ramanan849/Makerspace101_UTM_Monster/README.md

# Makerspace101 (MS101) Course Project 
[Project Report](https://github.com/ramanan849/Makerspace101_UTM_Monster/blob/47e68d466ecf8d2956a00e4f3acc10e7f7961b5e/B10_I_Project_report.pdf)
Course Project - MS101 - Autumn 2023-24 : Oct '23 to Nov '23
- Professors : Prof. Joseph John (EE), Prof. Arunkumar Sridharan (ME), Prof. Krishna N. Jonnalagadda (ME) and Prof. Janani Sree Muralidharan (ME)
- Team D2/B10/I
  Team Members:
  1. Arya Sameer Joshi (23B1853)
  2. Gokularamanan R S (23B1854)
  3. Tanay Amit Agrawal (23B1855)
  4. Ayush Singh (23B1856)
  5. Haris Narrendran R (23B1857)
  6. Aadi Suketu Bharatia (23B1858)
- THis repo contains:
  1. [Project Report](https://github.com/ramanan849/Makerspace101_UTM_Monster/blob/47e68d466ecf8d2956a00e4f3acc10e7f7961b5e/B10_I_Project_report.pdf)
  2. [Project Code](https://github.com/ramanan849/Makerspace101_UTM_Monster/blob/47e68d466ecf8d2956a00e4f3acc10e7f7961b5e/Final_as_of_6_11.ino)
  3. [Problem Statement](https://github.com/ramanan849/Makerspace101_UTM_Monster/blob/47e68d466ecf8d2956a00e4f3acc10e7f7961b5e/Project_Updated_26October2023.pdf)
  4. [Captured raw data](https://github.com/ramanan849/Makerspace101_UTM_Monster/blob/47e68d466ecf8d2956a00e4f3acc10e7f7961b5e/CoolTerm%20Capture%202023-11-10%2010-01-46.csv) and [Final Processed data](https://github.com/ramanan849/Makerspace101_UTM_Monster/blob/47e68d466ecf8d2956a00e4f3acc10e7f7961b5e/Final_processed%20data.pdf) obtained from breaking a sample.
  5. [Log File](https://github.com/ramanan849/Makerspace101_UTM_Monster/blob/47e68d466ecf8d2956a00e4f3acc10e7f7961b5e/MS%20101%20log%20file%20-%20detailed.pdf) - each team member's contribution to the project.
  6. [Video Review 1 (mid-term)](https://github.com/ramanan849/Makerspace101_UTM_Monster/blob/47e68d466ecf8d2956a00e4f3acc10e7f7961b5e/Review%201%20Video%20-%20Copy%20of%20B10%20I%20DH%20Final%20Rev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)
  
  **[Final Video Demonstration](https://youtu.be/UxlTlBXdOjU)**
