ramanan849/Makerspace101_UTM_Monster/B10_I_Project_report.pdf

/* CODE - Team B10/I
Gokularamanan R S 23B1854 | Arduino code

Arya Joshi 23B1853 - calibration
*/

#define mtrDirPin1 7 // In1 Pin on Motor Driver - Controls Motor Direction #define mtrDirPin2 8 // In2 Pin on Motor Driver - Controls Motor Direction

#define mtrEnPin 10 | // EnA Pin on Motor Driver - Turns Motor ON/OFF

#define irPin 2 | // This is the IR sensor's (near the encoder disc) Pin

#define currentPin A0 // This pin will be used to sense Motor Current #define isrTestPin 13 // This pin will toggle every time ISR is called

unsigned long pulseCount=0; // No of pulses counted
unsigned char index=0; | // A dummy index used to store time, Current and extension
readings in an array
/* we have used 3 gears - i) 5 teeth gear (attached to motor), ii) 25 teeth gear (intermediate), iii) 50 teeth gear (attached to leadscrew)
Hence, total gear ratio = 50/5 = 10 (intermediate gear doesn't contribute to gear ratio, it is just involved in reversing direction)
For every rotation made by 5-teeth gear, the 50-teeth gear moves 0.1 revolution (gear ratio = 10)*/
float rot = 0.0; // rot = number of rotations completed by the gear connected to the motor
float big = 0.0; // big = no. of rotations of 50-teeth gear
float extension = 0.0; // variable to store the displacements/ extension of sample in mm

void setup()
{
// This code will run once initially pinMode(mtrDirPin1,OUTPUT); pinMode(mtrDirPin2,OUTPUT);
pinMode(mtrEnPin,OUTPUT);
pinMode(irPin,INPUT);
attachInterrupt(digitalPinToInterrupt(irPin),pulseDetected,FALLING); pinMode(isrTestPin,OUTPUT);
Serial.begin(9600);
digitalWrite(mtrDirPin1,LOW);
digitalWrite(mtrDirPin2,HIGH);
// LOW(dir1) - HIGH(dir2) TO MAKE IT MOVE SUCH THAT SAMPLE STRETCHES AND BREAKS // HIGH(dir1) - LOW(dir2) TO MAKE IT MOVE IN FRONT digitalWrite(mtrEnPin,HIGH); // Full Speed
analogWrite(mtrEnPin, 128); // Variable Speed, set second parameter 0 - 255 /* Serial.print("Time, ");
Serial.print("Extension, ");
Serial.print("Current, ");
Serial.println("PulseCount");
//above print statements print in a csv format : Time, Extension, Current, PluseCount }

void loop(){

}

void pulseDetected() // This is the Interrupt Service Routine
{ // This will run everytime a falling edge is detected on the irPin digitalWrite(isrTestPin,!digitalRead(isrTestPin));
// The ISR Test Pin toggled everytime a falling edge is detected! pulseCount++; // detected a pulse; Increase the pule count by 1 index++;
if (index>=100)
{
index = 0;
}
// Index incrments with pulseCount but if it goes above 99, its resetted to 0
if (pulseCount % 8 ==0){ // checking whether one revolution is complete=> pulseCount/8 because, the disk given to us had 8 white sectors and 8 black sectors. The ir sensor detects a falling edge i.e., White to black strip transition. There are 8 such transitions in revolution.
rot = pulseCount/8;
big = rot/10;
extension = big * 1.5/2; // pitch of leadscrew = 1.5 mm => 1.5 mm displacement in 1 revolution of leadscrew; and dividing by 2 for calibration (we’re getting almost double the actual extension; we verified this by measuring the elongation in length of the broken sample)
float arr[4] = {millis()/1000,extension,analogRead(A0),pulseCount};
// to print timestamp, extension,current,pulsecount in csv format, i have printed commas below
Serial.print(arr[0],2); // arr[0] is the time and 2 is for no. of decimal places to display
Serial.print(",");
Serial.print(arr[1],3);
Serial.print(",");
Serial.print(arr[2],3);
Serial.print(",");
Serial.println(arr[3]);
}
}

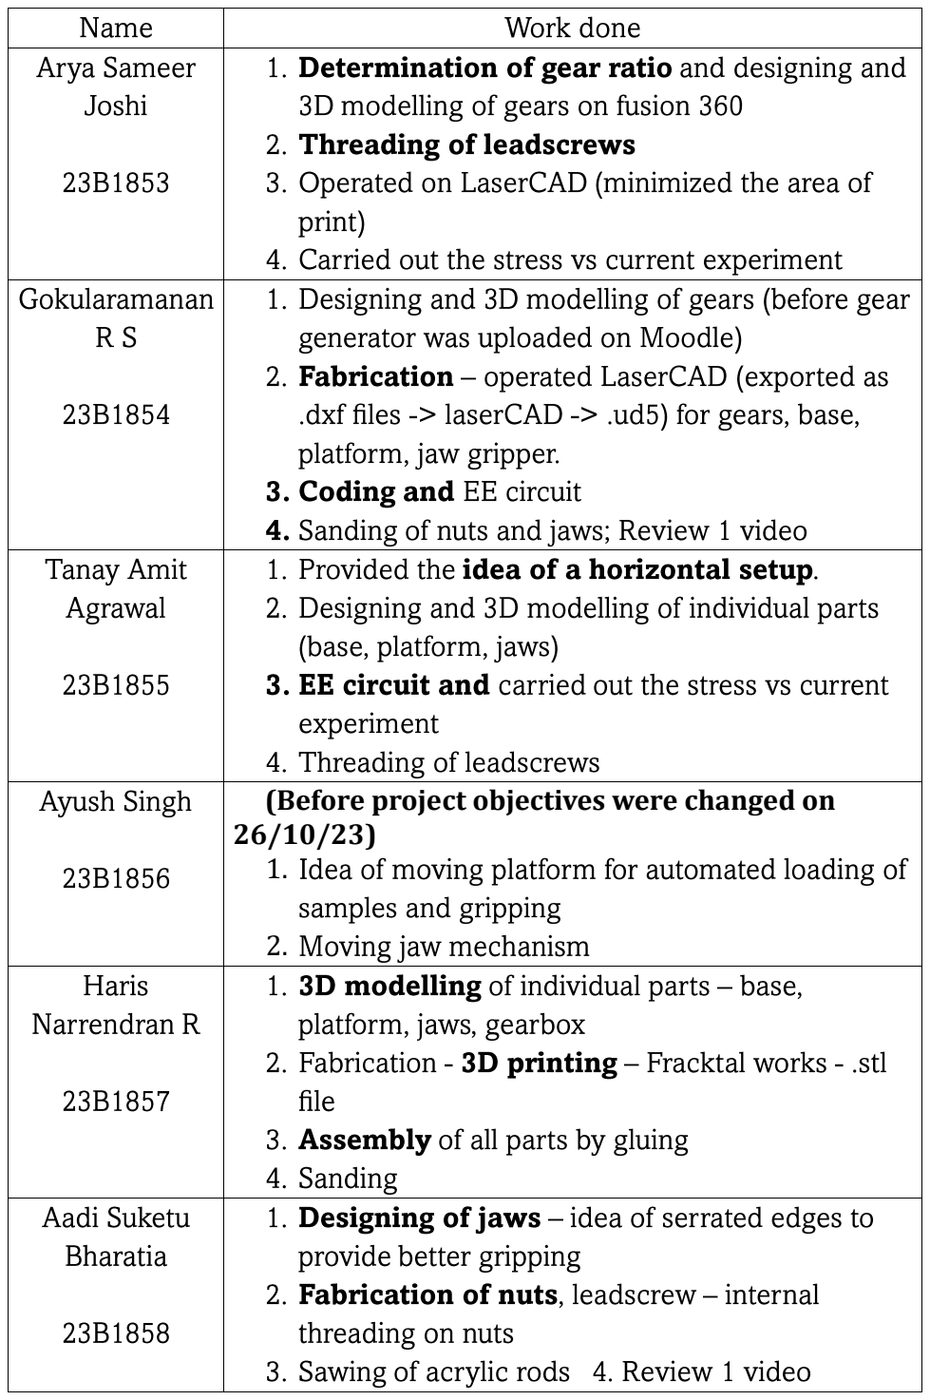
[picture p1: page 3]

## (Before project objectives were changed on

26/10/23)
1.

2.

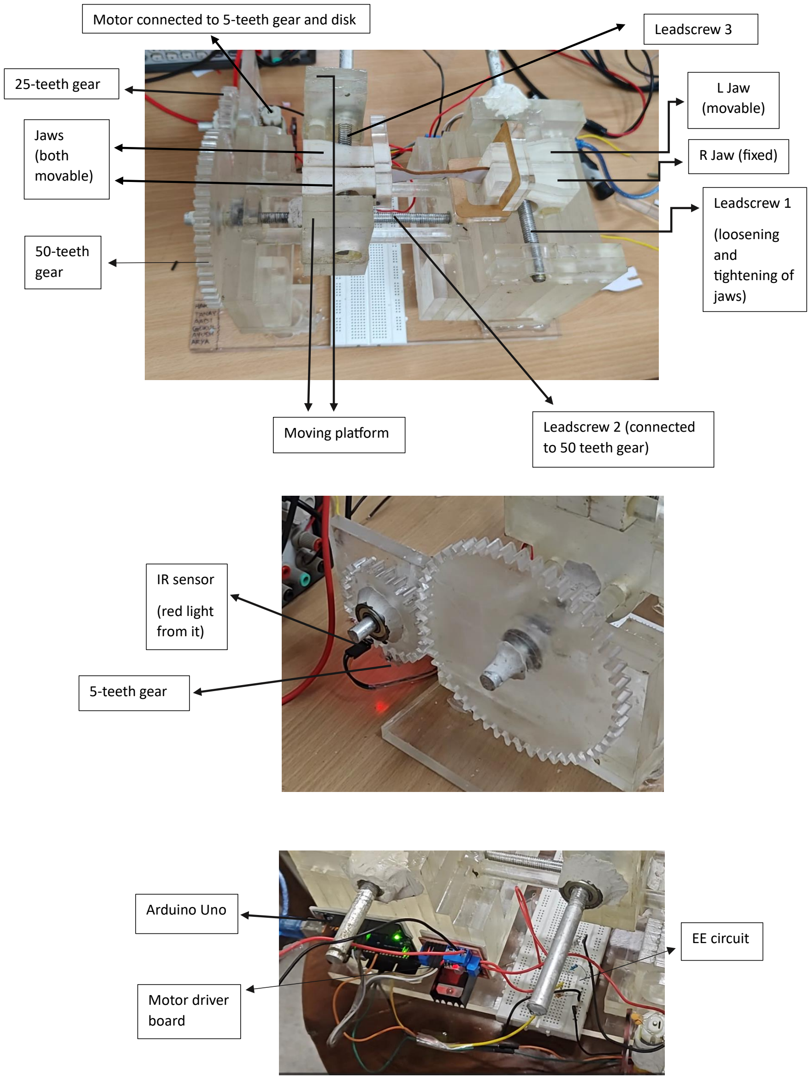
[picture p2: page 4]

L Jaw
(movable)

Leadscrew 1

(loosening
and
tightening of
jaws)

R Jaw (fixed)

Leadscrew 2 (connected
to 50 teeth gear)

Moving platform

Jaws
(both
movable)

Leadscrew 3 Motor connected to 5-teeth gear and disk

50-teeth
gear

25-teeth gear

5-teeth gear

EE circuit

Arduino Uno

Motor driver
board

IR sensor

(red light
from it)

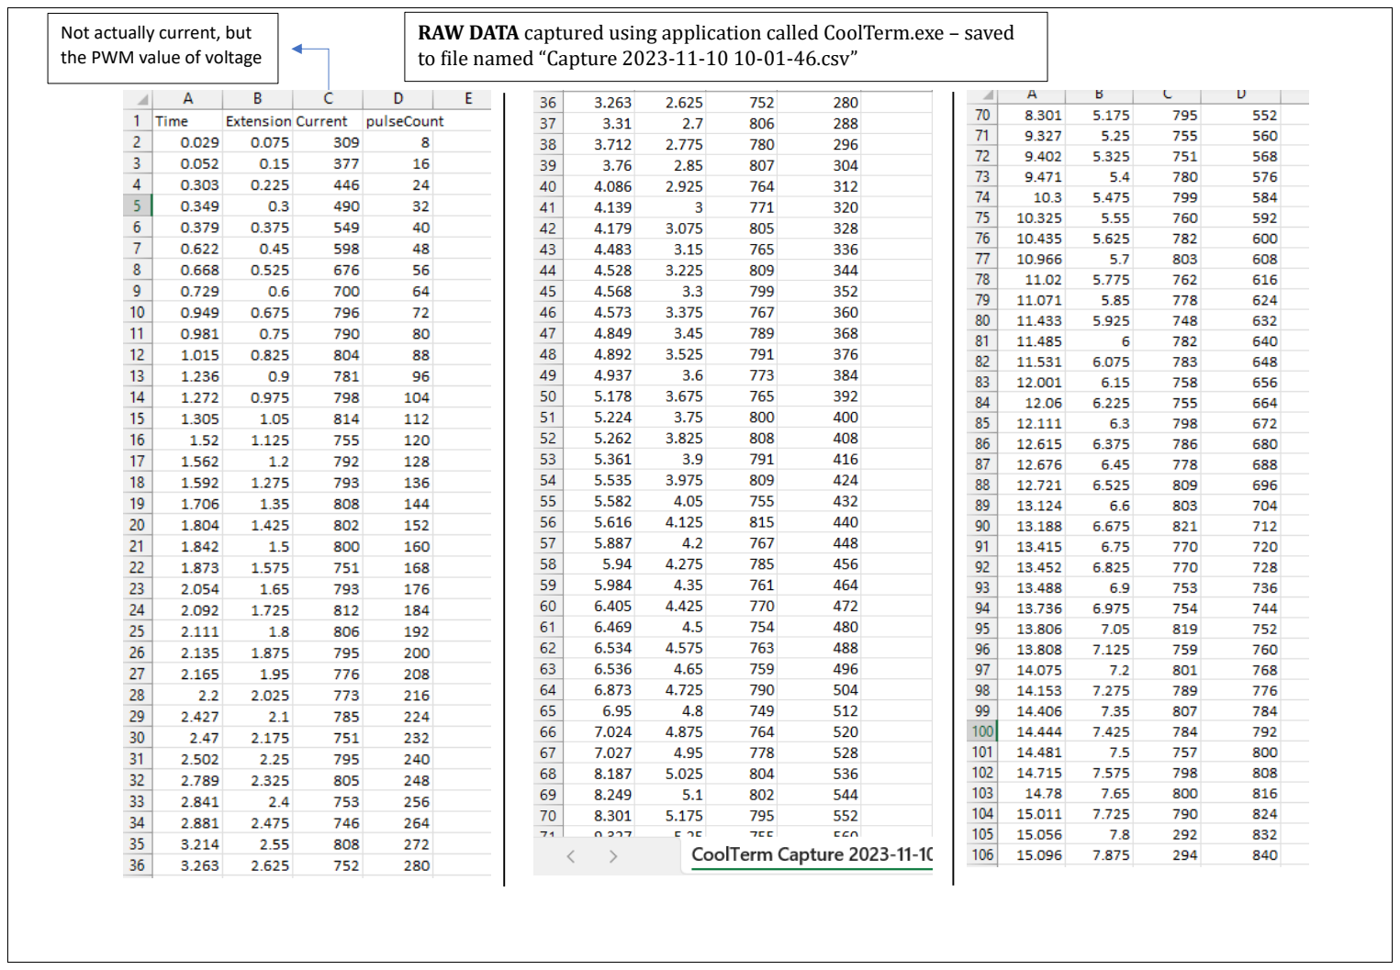
[picture p3: page 5]

RAW DATA captured using application called CoolTerm.exe – saved to file named “Capture 2023-11-10 10-01-46.csv”

Not actually current, but
the PWM value of voltage

# Processed Data:

## Actual Current (mA) =

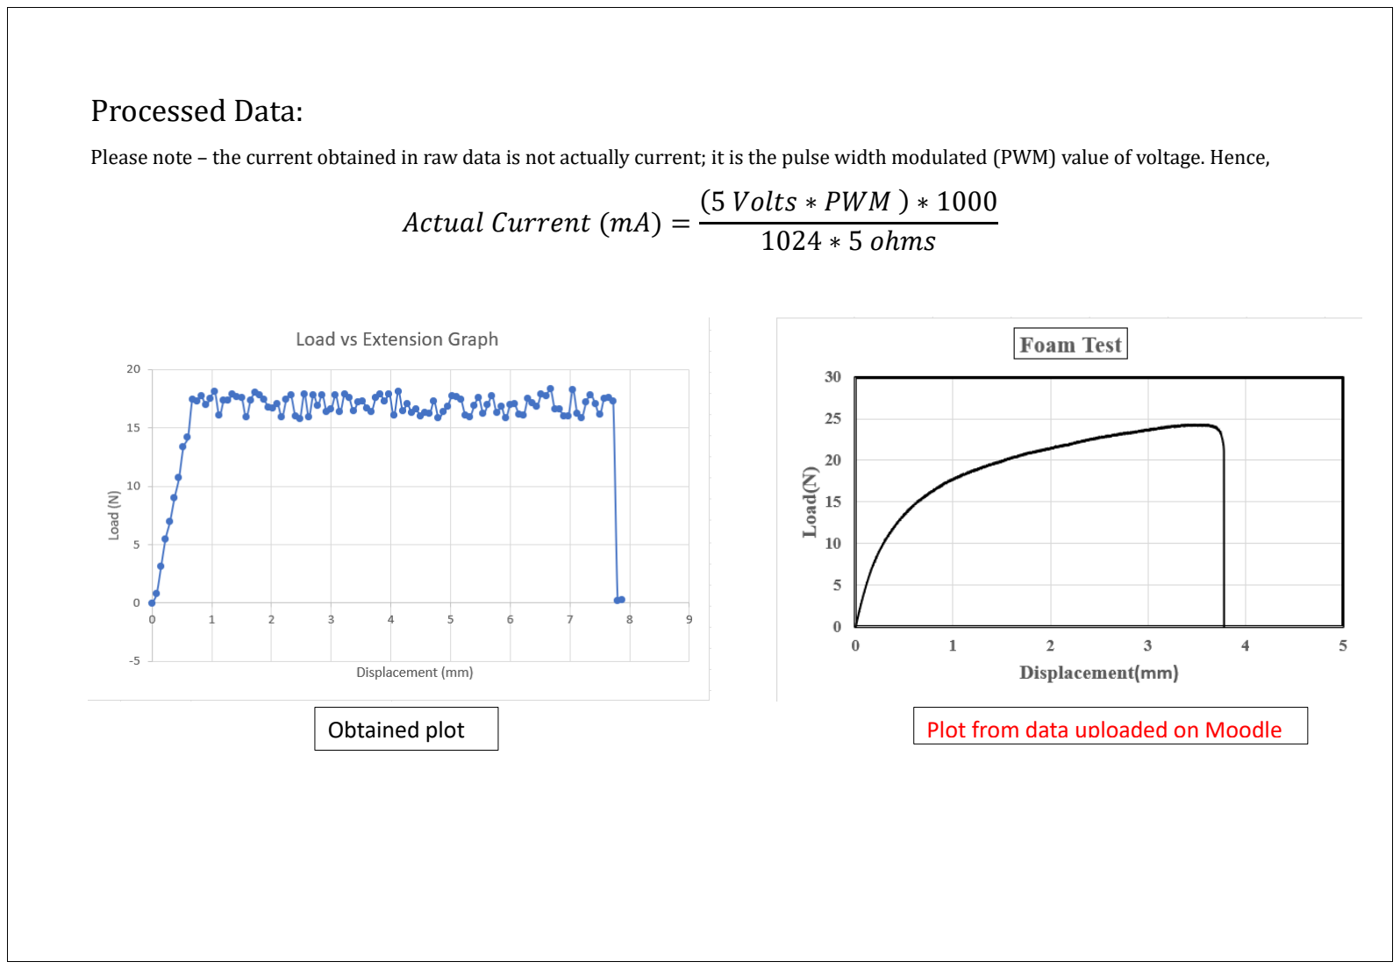
[picture p4: page 6]

Please note – the current obtained in raw data is not actually current; it is the pulse width modulated (PWM) value of voltage. Hence,

## (5 Volts ∗ PWM ) ∗ 1000 1024 ∗ 5 oℎms

Obtained plot | Plot from data uploaded on Moodle

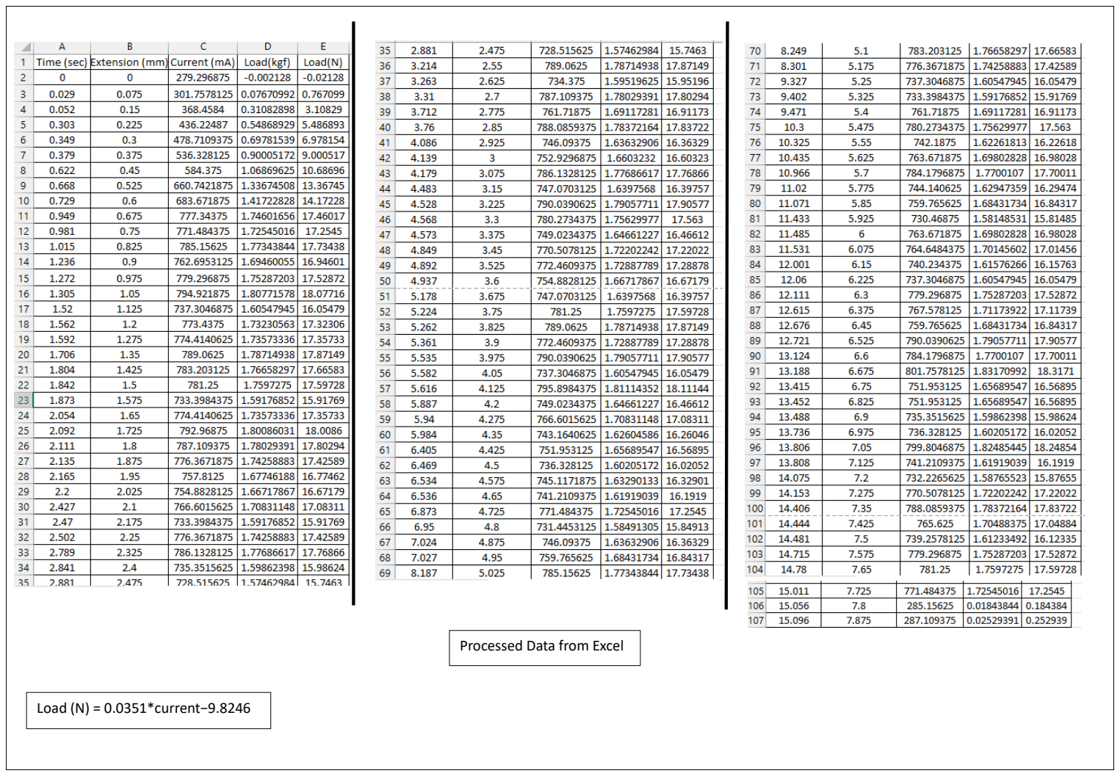
[picture p5: page 7]

Processed Data from Excel

Load (N) = 0.0351*current−9.8246

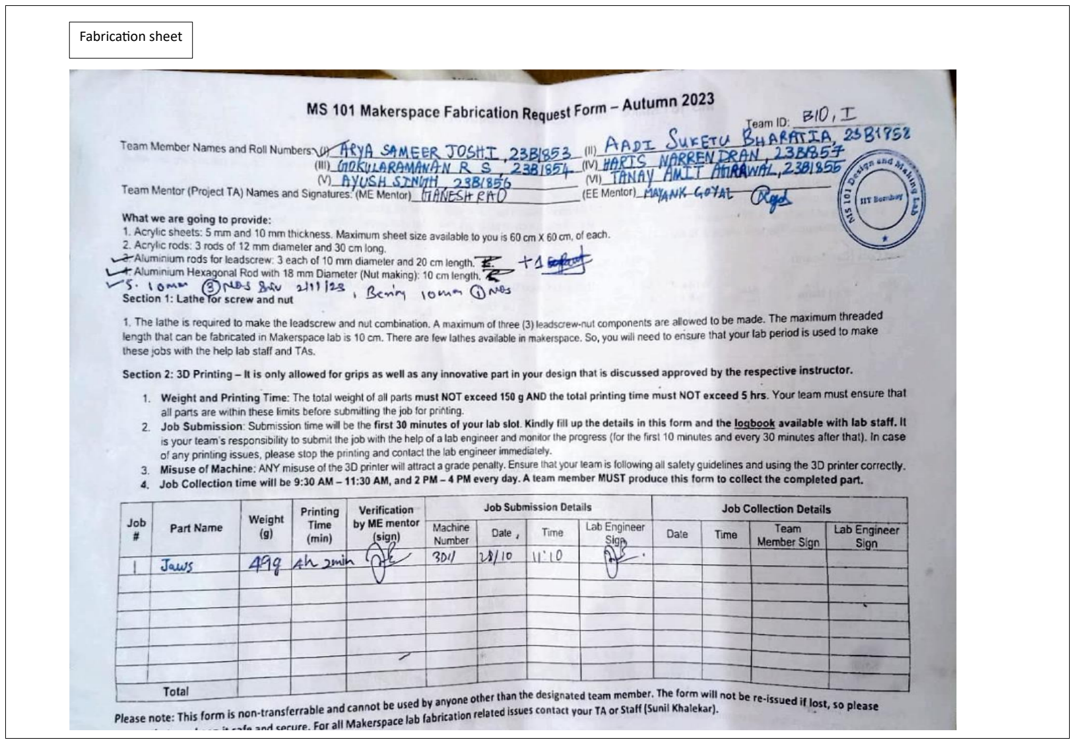
[picture p6: page 8]

Fabrication sheet

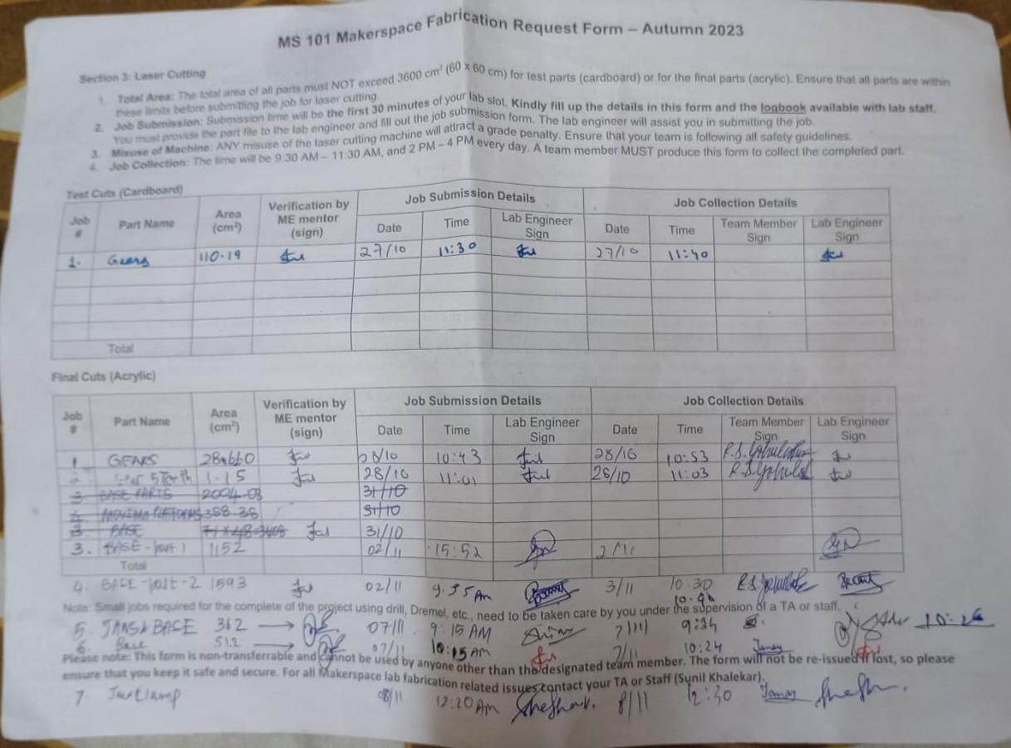
[picture p7: figure]

1. Gears –
28.66 cm^2
2. Gear 5
teeth –
1.15 cm^2
3. Base part 1
– 1152
cm^2
4. Base part 2
– 1593
cm^2
5. Jaws and
base – 312
cm^2
6. Base – 51.2
cm^2
7. Jaw clamp
– 9.1 cm^2

Total =
3157.4
cm^2

## Items bought:

S.No. | Item | Cost (Rs.)
1 | Acrylic glue x 2 | 402
2 | Mseal x 2 | 60
3 | Lubricant | 25
4 | Nail + screw | 5
5 | Feviqwik x 2 | 70
Total Cost = | | Rs. 562/-

## YouTube Link to video: https://youtu.be/UxlTlBXdOjU

Google Drive link for raw data and final processed data: https://drive.google.com/drive/folders/17-lyhXIEoWhwhJbMZq46x7ABxOXxxbGI?usp=drive_link (https://drive.google.com/drive/folders/17-lyhXIEoWhwhJbMZq46x7ABxOXxxbGI?usp=drive_link)

## Bibliography (external sources):

## 1. https://www.arduino.cc/reference/en/

## 2. https://www.ourpcb.com/coolterm-2.html

## 3. https://learn.sparkfun.com/tutorials/terminal-basics/coolterm-windows-mac-linux
