ramanan849/Makerspace101_UTM_Monster/Final_processed data.pdf

### Load vs Extension Graph

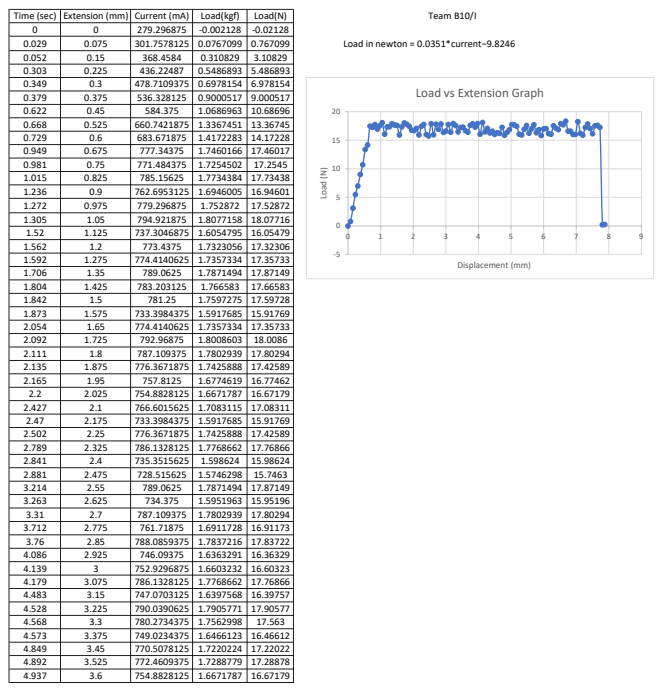
[picture p8: page 1]
Time (sec); Extension (mm); Current (mA); Load(kgf); Load(N); Team B10/I; 9 Load ⁽N⁾; Displacement (mm)

0 | 0 | 279.296875 | -0.002128 | -0.02128
0.029 | 0.075 | 301.7578125 | 0.0767099 | 0.767099
0.052 | 0.15 | 368.4584 | 0.310829 | 3.10829
0.303 | 0.225 | 436.22487 | 0.5486893 | 5.486893
0.349 | 0.3 | 478.7109375 | 0.6978154 | 6.978154
0.379 | 0.375 | 536.328125 | 0.9000517 | 9.000517
0.622 | 0.45 | 584.375 | 1.0686963 | 10.68696
0.668 | 0.525 | 660.7421875 | 1.3367451 | 13.36745
0.729 | 0.6 | 683.671875 | 1.4172283 | 14.17228
0.949 | 0.675 | 777.34375 | 1.7460166 | 17.46017
0.981 | 0.75 | 771.484375 | 1.7254502 | 17.2545
1.015 | 0.825 | 785.15625 | 1.7734384 | 17.73438
1.236 | 0.9 | 762.6953125 | 1.6946005 | 16.94601
1.272 | 0.975 | 779.296875 | 1.752872 | 17.52872
1.305 | 1.05 | 794.921875 | 1.8077158 | 18.07716
1.52 | 1.125 | 737.3046875 | 1.6054795 | 16.05479
1.562 | 1.2 | 773.4375 | 1.7323056 | 17.32306
1.592 | 1.275 | 774.4140625 | 1.7357334 | 17.35733
1.706 | 1.35 | 789.0625 | 1.7871494 | 17.87149
1.804 | 1.425 | 783.203125 | 1.766583 | 17.66583
1.842 | 1.5 | 781.25 | 1.7597275 | 17.59728
1.873 | 1.575 | 733.3984375 | 1.5917685 | 15.91769
2.054 | 1.65 | 774.4140625 | 1.7357334 | 17.35733
2.092 | 1.725 | 792.96875 | 1.8008603 | 18.0086
2.111 | 1.8 | 787.109375 | 1.7802939 | 17.80294
2.135 | 1.875 | 776.3671875 | 1.7425888 | 17.42589
2.165 | 1.95 | 757.8125 | 1.6774619 | 16.77462
2.2 | 2.025 | 754.8828125 | 1.6671787 | 16.67179
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
14.481 | 7.5 | 739.2578125 | 1.6123349 | 16.12335
14.715 | 7.575 | 779.296875 | 1.752872 | 17.52872
14.78 | 7.65 | 781.25 | 1.7597275 | 17.59728
15.011 | 7.725 | 771.484375 | 1.7254502 | 17.2545
15.056 | 7.8 | 285.15625 | 0.0184384 | 0.184384
15.096 | 7.875 | 287.109375 | 0.0252939 | 0.252939
